clubroboticagranada/semaforo-optico-acustico-CO2/README.md

# Semáforo óptico-acústico de CO2 y nivel de ruido
Veremos como crear y programar el dispositivo.

[Acceso a los contenidos](https://clubroboticagranada.github.io/semaforo-optico-acustico-CO2/)
