clubroboticagranada/semaforo-optico-acustico-CO2/docs/modular/modular.md

# Versión modular

Se trata de la versión dirigida a usuarios con cierta experiencia en trabajo con placas tipo Arduino y sensores diversos.

La opción adoptada permite el cableado del equipo final sin necesidad de utilizar placas breadboard al usar la placa UNO con pines extendidos de Keyestudio y que todos los sensores disponen de conexiones de pines tipo dupont.

A continuación tenemos una tabla a modo de lista de materiales gráfica con enlaces a sitios de compra.

<center>

| Cantidad | Descripción | Imagen |
|:-:|---|:-:|
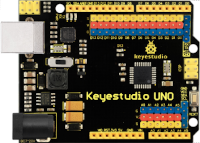
[picture p13: docs/img/modular/i1.png]
Ks0172-UNO pines extendidos
| 1 |keyestudio UNO con inteface de pines extendidos |  |
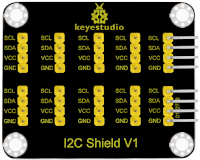
[picture p14: docs/img/modular/i2.png]
KS0392-HUB I2C
| 1 | Placa de conversión tipo HUB I2C |  |
| 1 | Sensor de Dioxido de Carbono | KS0457-CCS811-sensor CO2 |
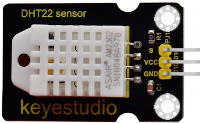
[picture p15: docs/img/modular/i4.png]
KS0430-sensor de temperatura y humedad
| 1 | Sensor de temperatura y humedad relativa |  |
| 1 | Amplificador de 2W de potencia| KS0374-amplificador de 2W de potencia |
| 1 | Micrófono sensor de sonido ambiente | KS0035-micrófono |
| 1 | Barómetro BMP280| KS0405-BMP280 |
| 1 | Pantalla LCD 1602 I2C | Ks0061-LCD |
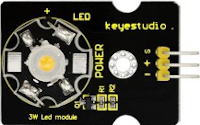
[picture p16: docs/img/modular/i9.png]
Ks0010-LED 3W
| 3 | LED de 3W |  |
| 1 | Alimentador Arduino 12V - 2A | Alimentador |
| 1 | Interruptor de panel deslizante 1P2T SPDT de 0.5A 50V CC | Interruptor de panel deslizante 1P2T SPDT de 0.5A 50V CC |
| 1 | Cables tipo dupont H-H de 10 cm y 4 pines| Cables H-H de 10 cm |
| 4 | Cable tipo dupont H-H de 30 cm y 3 pines| Cables dupont H-H |
| 3 | Cable tipo dupont H-H de 30 cm y 4 pines| Cables dupont H-H |
| 1 | Cable tipo dupont H-H de 30 cm y 5 pines| Cables dupont H-H |
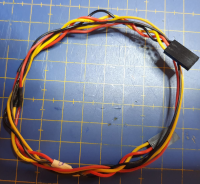
[picture p17: docs/img/modular/ic3.png]
Cable para color verde
| 1 | Cable tipo dupont H-H de 40 cm y 3 pines|  |
| 1 | Cable tipo dupont H-H de 45 cm y 3 pines| Cable para color amarillo |
| 1 | Cable tipo dupont H-H de 50 cm y 3 pines| Cable para color rojo |
| 1 | **OPCIONAL** Shield WiFi ESP01 <br> [Ver nota final Introducción](../index.md) </br> | KS0385-Shield WiFi ESP01 |
| 1 | **OPCIONAL** Módulo ESP8266 WiFi ESP01  <br> [Ver nota final Introducción](../index.md) </br> | Módulo ESP8266 WiFi ESP01 |

</center>
