clubroboticagranada/semaforo-optico-acustico-CO2/docs/Miscelanea/soft.md

# Software utilizado

* Dibujo 3D [FreeCAD 0.18 / FreeCAD 0.19](https://www.freecadweb.org/)
  
* Sistema operativo: [Ubuntu 20.04 LTS (Focal Fosa)](https://releases.ubuntu.com/bionic/)
  
* Paquete ofimático de referencia: [LibreOffice 7.0](https://es.libreoffice.org/)
  
* Librería Material para MkDocs
  
* [Visual Studio Code](https://code.visualstudio.com/)
  
* Creación de GIF animados para Ubuntu [Peek](https://ubunlog.com/peek-gif-animados-ubuntu/)
  
* Sistema principal de capturas de pantalla: [Shutter 0.94](http://shutter-project.org)
  
* Sistema secundario de capturas de pantalla: [Flameshot 0.6.0](https://flameshot.js.org/#/?id=flameshot-060)
  
* Dibujo 2D vectorial [Inkscape 1.0](https://inkscape.org/es/)

* Retoque de imágenes [GIMP 2.10.14](https://www.gimp.org/)

* Software online de programación por bloques creado por Juanjo López [ArduinoBlocks](http://www.arduinoblocks.com/) junto con el programa [connector](http://www.arduinoblocks.com/web/site/abconnector) que nos permitirá grabar los programas en la placa.

* [Libros y documentación](http://www.arduinoblocks.com/web/site/doc) sobre ArduinoBlocks
