clubroboticagranada/semaforo-optico-acustico-CO2/docs/mcu/mcu.md

# Versión Node MCU

Se trata de la versión dirigida a usuarios con bastante experiencia en trabajo con placas tipo Arduino y sensores diversos.

Requiere conocimientos de IoT.
