clubroboticagranada/semaforo-optico-acustico-CO2/docs/Miscelanea/webgrafia.md

# Webgrafía y bibliografía

***
* [Wikipedia](https://es.wikipedia.org/wiki/Wikipedia:Portada)

* [Carburos metálicos](http://www.carburos.com/), páginas 8 y 9 de la [Ficha Técnica de Seguridad número 300000000020](http://www.carburos.com/microsite/es/selector-gases-soldadura/pdf/SDS/CO2.pdf)  

* [Definiciones de términos usuales](https://www.nj.gov/health/eoh/rtkweb/documents/fs/0343sp.pdf) del Departamento de Salud de New Jersey.

* [Ficha de seguridad oficial del CO2](http://www.ilo.org/dyn/icsc/showcard.display?p_card_id=21&p_edit=&p_version=2&p_lang=es)

* Instituto para la Salud Geoambiental, [El dióxido de carbono](https://www.saludgeoambiental.org/dioxido-carbono-co2#:~:text=El%20di%C3%B3xido%20de%20carbono%20CO2,a%20vida%20en%20la%20Tierra)

* Artículo de la International Journal of Emergency Medicine [Carbon dioxide poisoning: a literature review of an often forgotten cause of intoxication in the emergency department](https://intjem.biomedcentral.com/articles/10.1186/s12245-017-0142-y)

* Artículo Editorial de BMJ: [Riesgos de transmisión de covid-19 en distintas situaciones](https://www.bmj.com/content/370/bmj.m3223)

Artículo del Centro Canadiense de Seguridad y Salud Ocupacional (CCSSO) sobre [Dióxido de Carbono - Efectos en la Salud](http://www.ccsso.ca/oshanswers/chemicals/chem_profiles/carbon_dioxide/health_cd.html)

* Muy recomendable para otros muchos temas el [Canal Youtube de Andreas Spiess](https://www.youtube.com/c/AndreasSpiess/about)

* Página web [SENSORSIOT/](https://www.sensorsiot.org/) de Andreas Spiess
