clubroboticagranada/semaforo-optico-acustico-CO2/docs/mega/mega.md

# Versión IoT con placa MEGA

Se trata de una versión muy similar a la modular pero solucionando los problemas de memoria de la versión con UNO y dando conectividad via WiFi al sistema para subir datos a la nube.

Básicamente todo es igual pero se aprovecha para implementar algunas mejoras respecto al prototipo modular y se incluye información referente a MQTT y WiFi interesante.
