clubroboticagranada/semaforo-optico-acustico-CO2/docs/Miscelanea/about.md

# Autores

<center>

| Angela Pozo | Federico Coca |
|:-:|:-:|
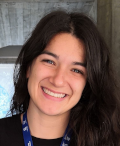
[picture p36: docs/img/angela.png]
Foto
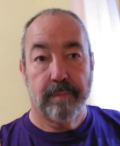
[picture p37: docs/img/YO.png]
Foto de perfil
| |  |
|[Github](https://github.com/ankgiel) | [GitHub](https://github.com/fgcoca) |
|[Twitter](http://twitter.com/ankgiel) | [Twitter](https://twitter.com/fgcoca) |
|[Instagram](https://www.instagram.com/ankgiel/?hl=es) |[Instagram](https://www.instagram.com/cocafederico/?hl=es) |
|[Mas información](../Miscelanea/about_angela.md) | [Mas información](https://fgcoca.github.io/Como-documento/about/) |

</center>
