clubroboticagranada/semaforo-optico-acustico-CO2/docs/Miscelanea/about_angela.md

# Un poco de mi huella digital

**Ángela Pozo Mateos** 

Soy **graduada en Ingeniería Informática** con un máster de profesorado en la especialidad de informática y, actualmente, trabaja como profesora en un centro de formación profesional para los ciclos de la familia de informática y telecomunicaciones.

Mis intereses están centrados en la creación de proyectos electrónicos con aplicaciones informáticas, siempre fomentando el uso de nuevas tecnologías y software libre. 

Trabajo en varios proyectos que tienen como objetivo promover la igualdad de género en las tecnologías: 

* proyecto [Seré Ingeniera](https://sereingeniera.ugr.es/)
* talleres para la Feria de las Ingenierías
* talleres para la semana de la Mujer y la niña en la Ciencia
* participación en la noche Europea de los Investigadores.
  
Estoy comprometida con la cultura Maker siendo miembro de:

* [ETSIIT Makers](http://www.etsiitmakers.org/)
* [Club Robótica Granada](https://clubroboticagranada.github.io/)
