clubroboticagranada/semaforo-optico-acustico-CO2/docs/img/sobre-co2/i1.pdf

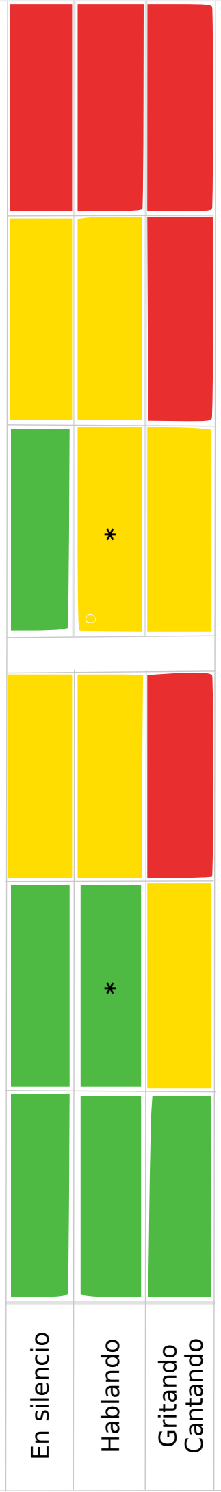
[picture p38: figure]
En silencio; Hablando; Gritando; Cantando
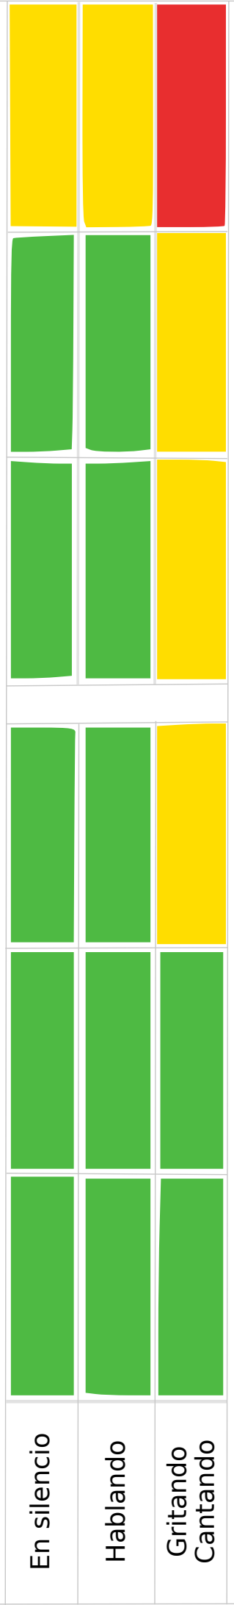
[picture p39: figure]
En silencio; Hablando; Gritando; Cantando
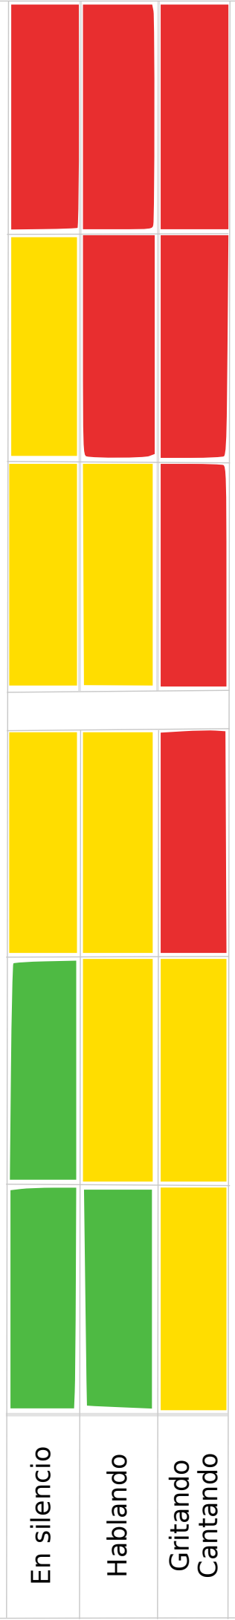
[picture p40: figure]
En silencio; Hablando; Gritando; Cantando

Tipo y nivel de
actividad del
grupo

Baja ocupación Alta ocupación

Aire libre y

bien ventilado

Interior y

bien ventilado

Mal

ventilado

Aire libre y

bien ventilado

Interior y

bien ventilado

Mal

ventilado

Con mascarilla bien colocada y contacto durante poco tiempo

Con mascarilla bien colocada y contacto durante mucho tiempo Sin mascarilla o mal colocada y contacto durante poco tiempo

Sin mascarilla o mal colocada y contacto durante mucho tiempo

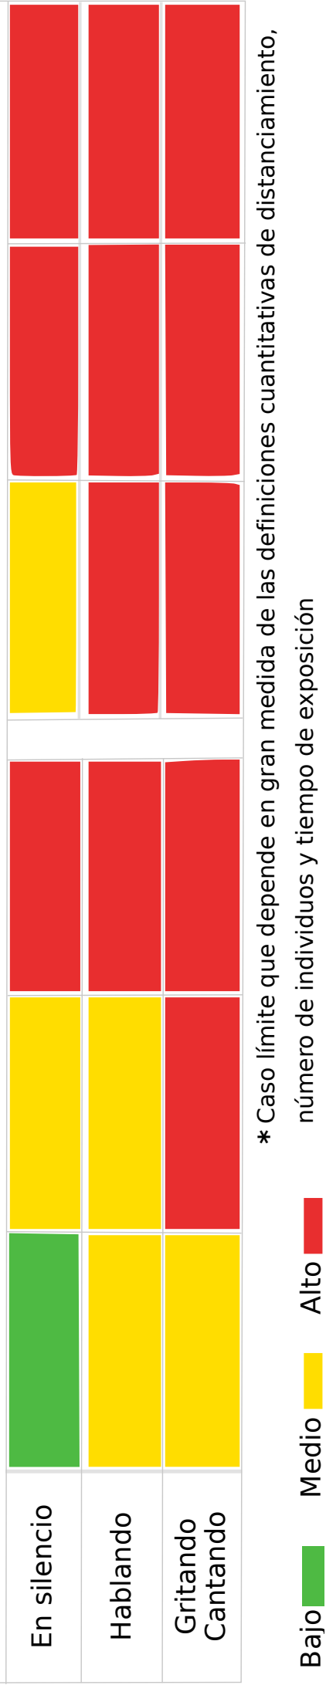
[picture p41: figure]
En silencio; Hablando; Gritando; Cantando; Bajo Medio Alto

Caso límite que depende en gran medida de las definiciones cuantitativas de distanciamiento,

número de individuos y tiempo de exposición
