clubroboticagranada/semaforo-optico-acustico-CO2/docs/modular/pinout/Ks0172-keyestudio-UNO.png

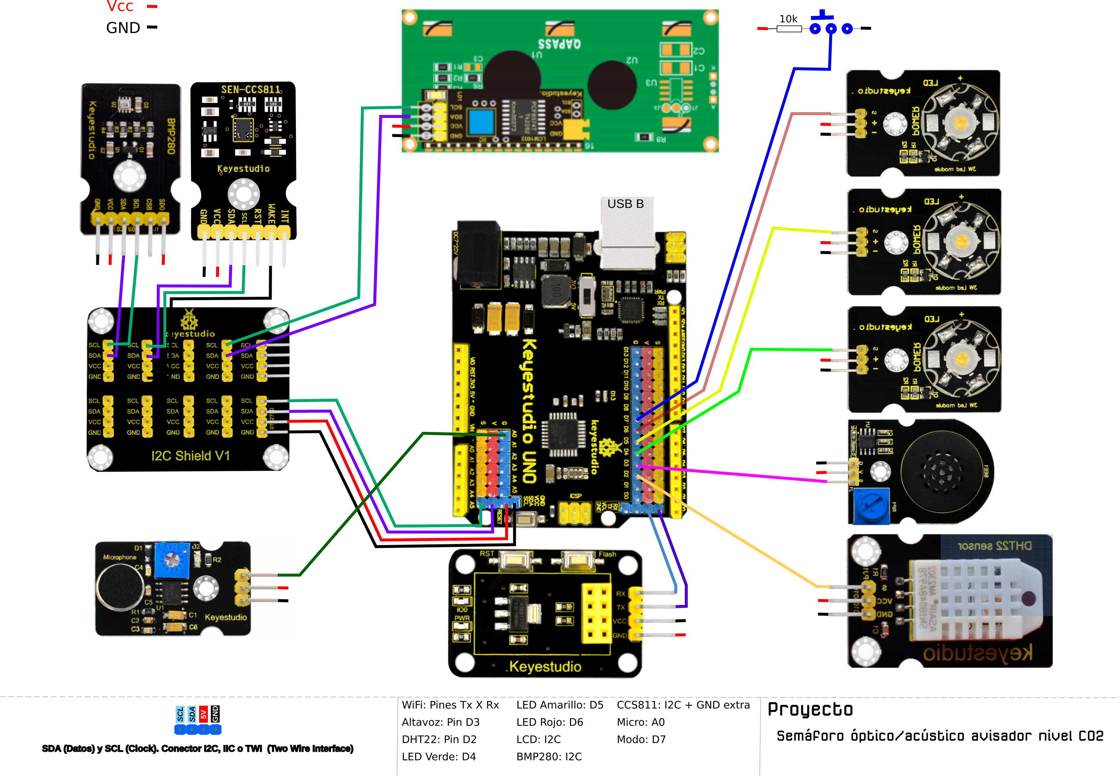
docs/modular/pinout/Ks0172-keyestudio-UNO.png
