clubroboticagranada/semaforo-optico-acustico-CO2/site/img/mega/sensor/i5ant.png

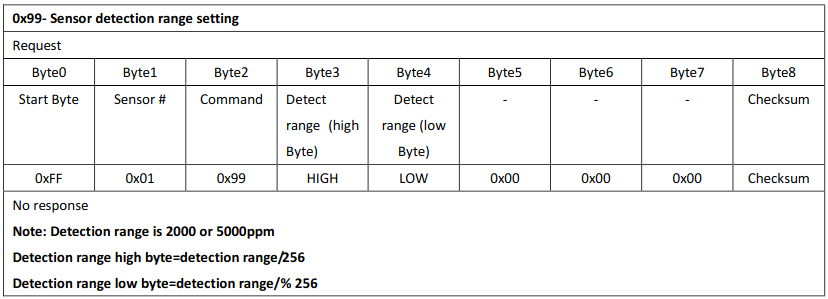
site/img/mega/sensor/i5ant.png
