clubroboticagranada/semaforo-optico-acustico-CO2/site/img/mega/sensor/i6ant.png

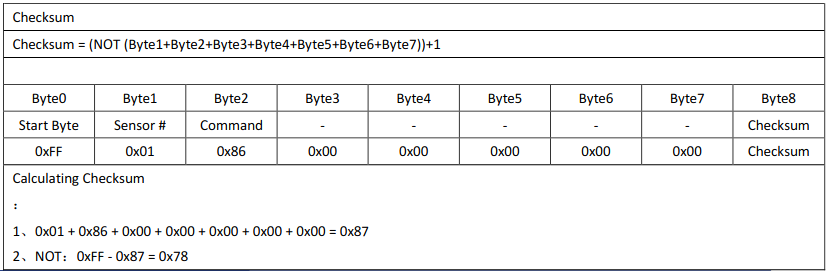
site/img/mega/sensor/i6ant.png
