clubroboticagranada/semaforo-optico-acustico-CO2/site/img/modular/firmware/i8.png

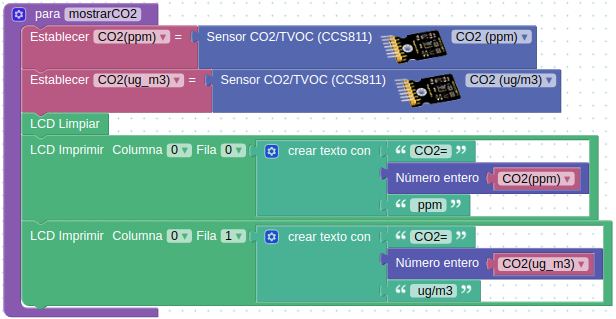
site/img/modular/firmware/i8.png
