clubroboticagranada/semaforo-optico-acustico-CO2/site/img/modular/firmware/i9.png

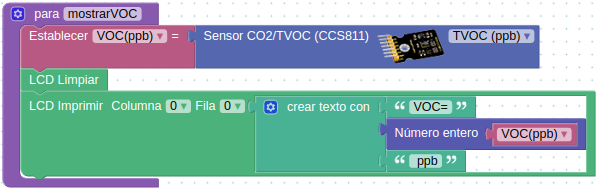
site/img/modular/firmware/i9.png
