clubroboticagranada/semaforo-optico-acustico-CO2/site/modular/pinout/imagenes-referencia/Amplificador.png

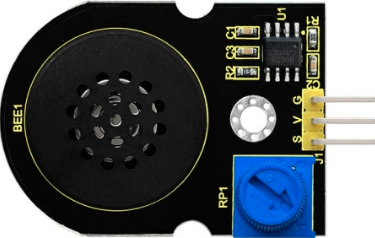
site/modular/pinout/imagenes-referencia/Amplificador.png
