clubroboticagranada/semaforo-optico-acustico-CO2/site/modular/pinout/imagenes-referencia/DHT22.png

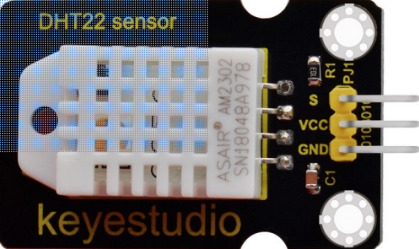
site/modular/pinout/imagenes-referencia/DHT22.png
