clubroboticagranada/semaforo-optico-acustico-CO2/site/modular/pinout/imagenes-referencia/Hub-I2C.png

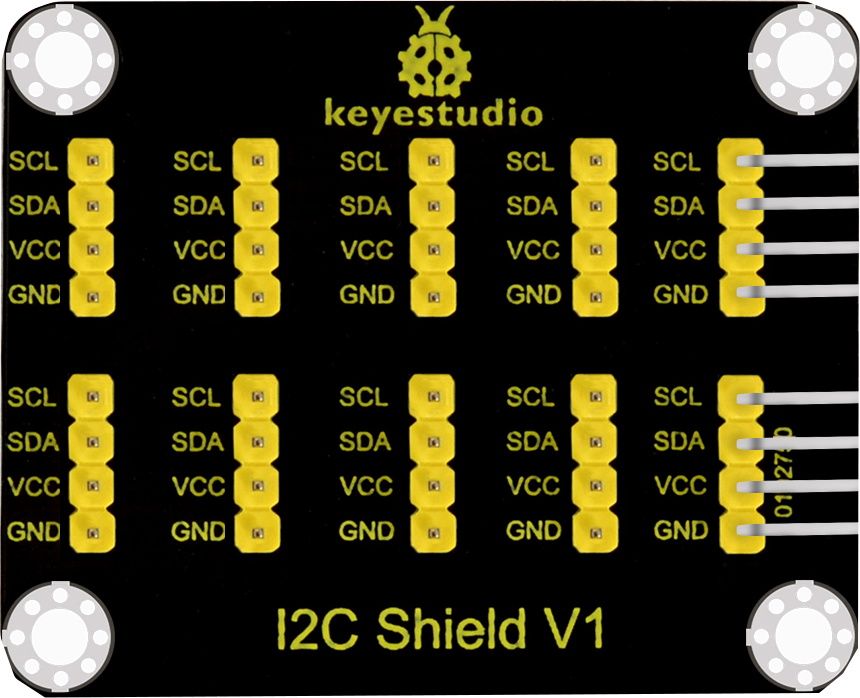
site/modular/pinout/imagenes-referencia/Hub-I2C.png
