clubroboticagranada/semaforo-optico-acustico-CO2/site/modular/pinout/imagenes-referencia/LCD1602.png

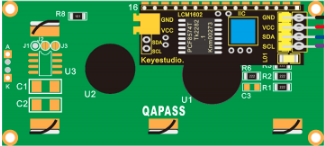
site/modular/pinout/imagenes-referencia/LCD1602.png
