clubroboticagranada/semaforo-optico-acustico-CO2/site/modular/pinout/imagenes-referencia/LED-3W.png

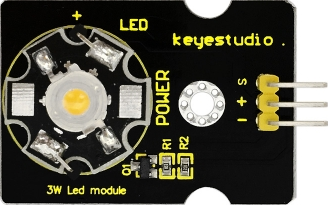
site/modular/pinout/imagenes-referencia/LED-3W.png
