clubroboticagranada/semaforo-optico-acustico-CO2/site/modular/pinout/imagenes-referencia/Microfono.png

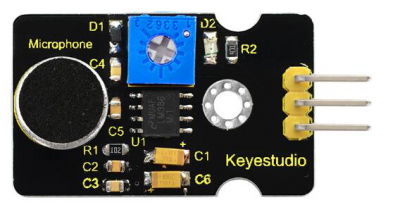
site/modular/pinout/imagenes-referencia/Microfono.png
