clubroboticagranada/semaforo-optico-acustico-CO2/site/modular/pinout/imagenes-referencia/WiFi.png

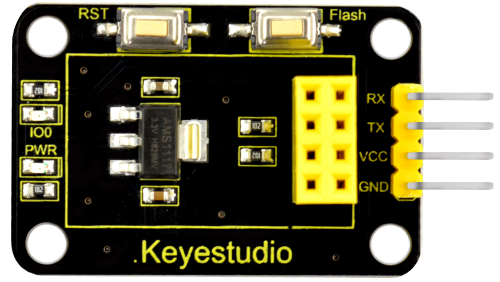
site/modular/pinout/imagenes-referencia/WiFi.png
