clubroboticagranada/semaforo-optico-acustico-CO2/docs/3D/design/design.FCStd

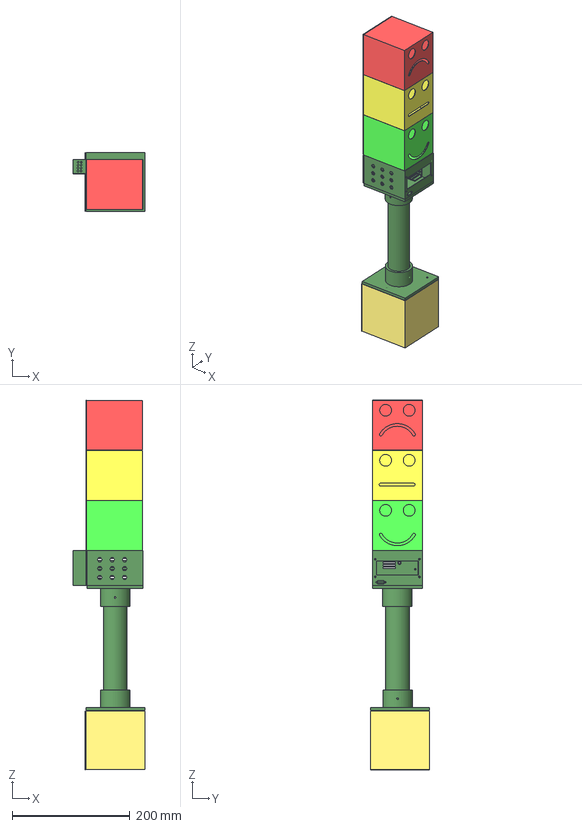
[picture p54: CAD file, 2020-10-14]
docs/3D/design/design.FCStd
122.0 x 100.2 x 628.5 mm
tapa-posterior-verde-e
tubo-200mm-e
tapa-posterior-amarillo-e
tapa-posterior-rojo-e
separador-e
soporte-tubo-inferior-e
caja-sensores-e
verde-e
amarillo-e
rojo-e
soporte-tubo-superior-e
caja-CCS811-e
tapa-caja-CCS812-e
tapa-posterior-sensores-e
base-e
tapa-posterior-base-e
