clubroboticagranada/semaforo-optico-acustico-CO2/docs/3D/step/tapa-posterior-base.step

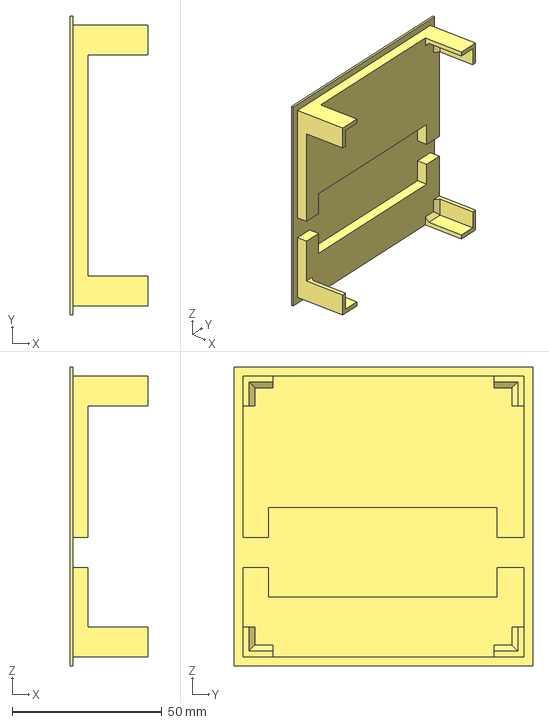
[picture p55: CAD file, 2020-10-14]
docs/3D/step/tapa-posterior-base.step
26.0 x 100.0 x 100.0 mm
