clubroboticagranada/semaforo-optico-acustico-CO2/site/3D/step/tapa-posterior-sensores.step

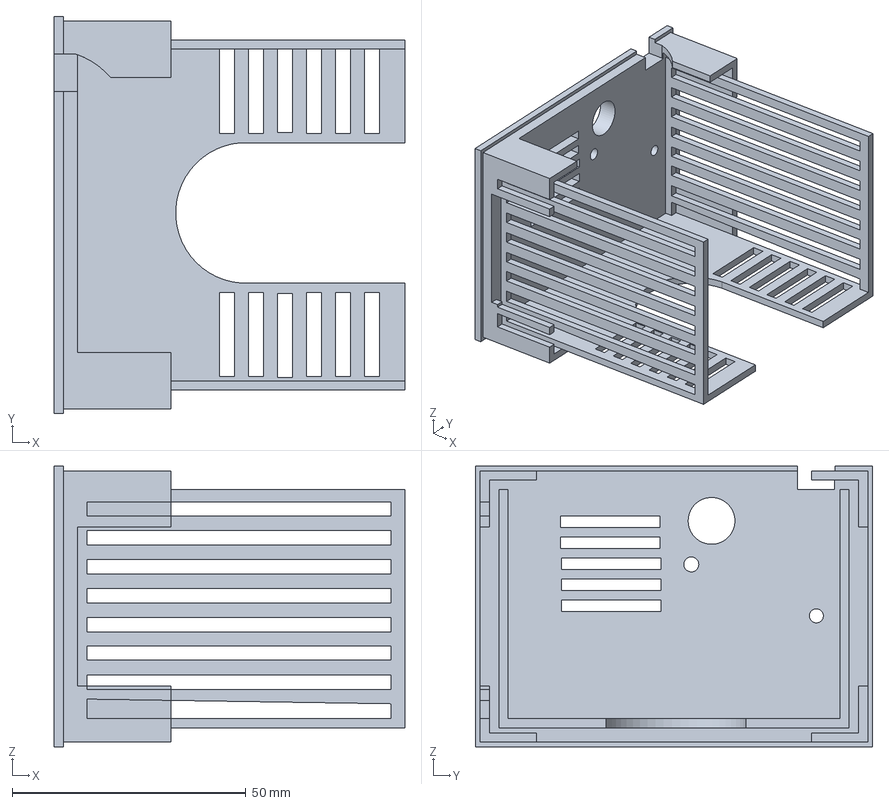
[picture p56: CAD file, 2020-10-05]
site/3D/step/tapa-posterior-sensores.step
75.0 x 84.9 x 60.0 mm
