clubroboticagranada/semaforo-optico-acustico-CO2/site/3D/step/tapa-posterior-verde.step

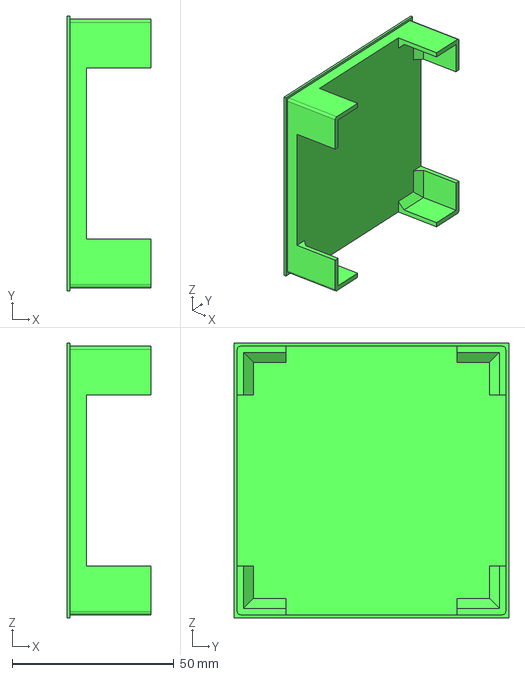
[picture p57: CAD file, 2020-10-05]
site/3D/step/tapa-posterior-verde.step
26.0 x 84.9 x 84.9 mm
