clubroboticagranada/semaforo-optico-acustico-CO2/site/3D/step/rojo.step

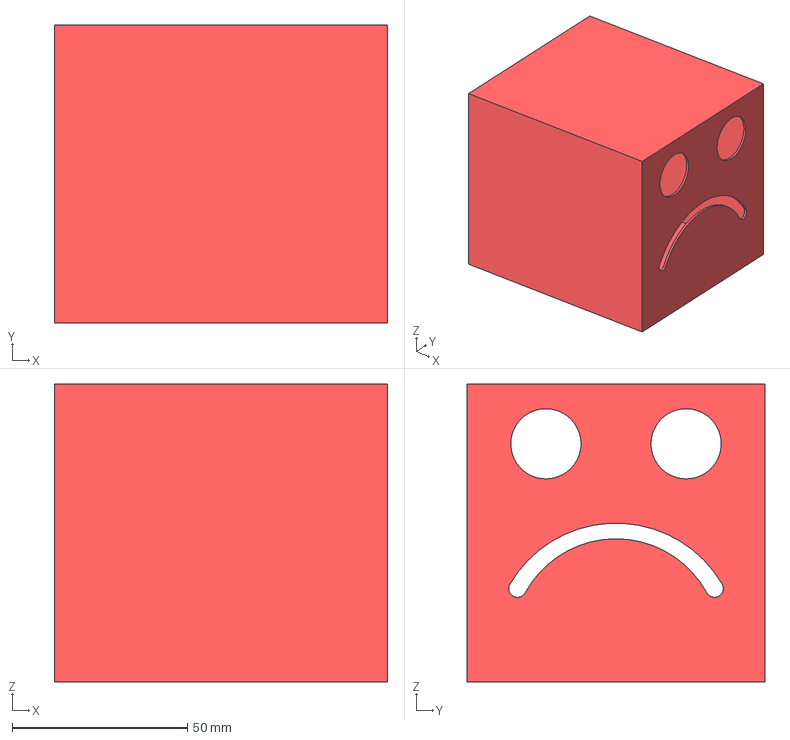
[picture p58: CAD file, 2020-10-05]
site/3D/step/rojo.step
95.0 x 84.9 x 84.9 mm
