clubroboticagranada/semaforo-optico-acustico-CO2/site/3D/step/caja-sensores.step

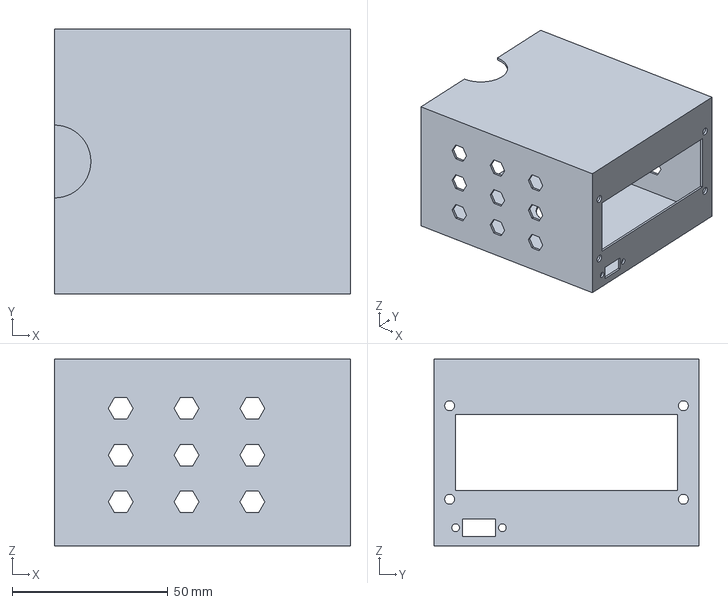
[picture p59: CAD file, 2020-10-05]
site/3D/step/caja-sensores.step
95.0 x 84.9 x 60.0 mm
