clubroboticagranada/semaforo-optico-acustico-CO2/site/3D/step/tapa-caja-CCS812.step

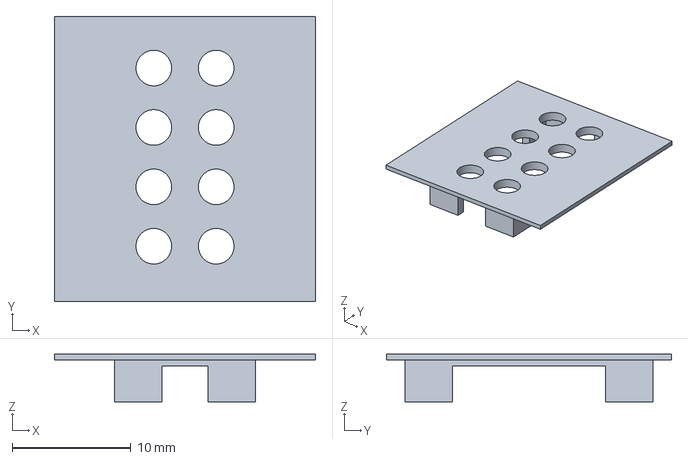
[picture p60: CAD file, 2020-10-05]
site/3D/step/tapa-caja-CCS812.step
22.0 x 24.0 x 4.00 mm
