clubroboticagranada/semaforo-optico-acustico-CO2/site/3D/step/caja-CCS811.step

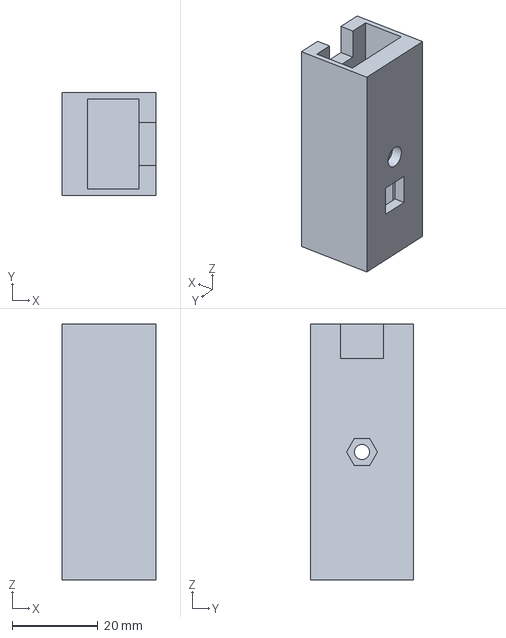
[picture p61: CAD file, 2020-10-05]
site/3D/step/caja-CCS811.step
22.0 x 24.0 x 59.6 mm
