clubroboticagranada/semaforo-optico-acustico-CO2/site/3D/step/separador.step

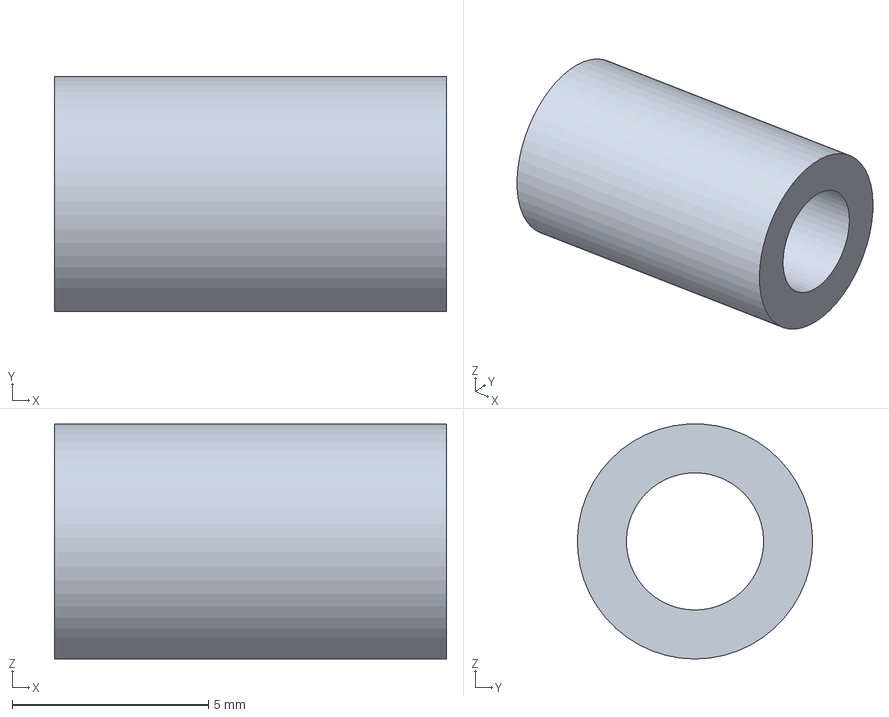
[picture p62: CAD file, 2020-10-05]
site/3D/step/separador.step
10.0 x 6.00 x 5.99 mm
