clubroboticagranada/semaforo-optico-acustico-CO2/site/3D/step/soporte-tubo-inferior.step

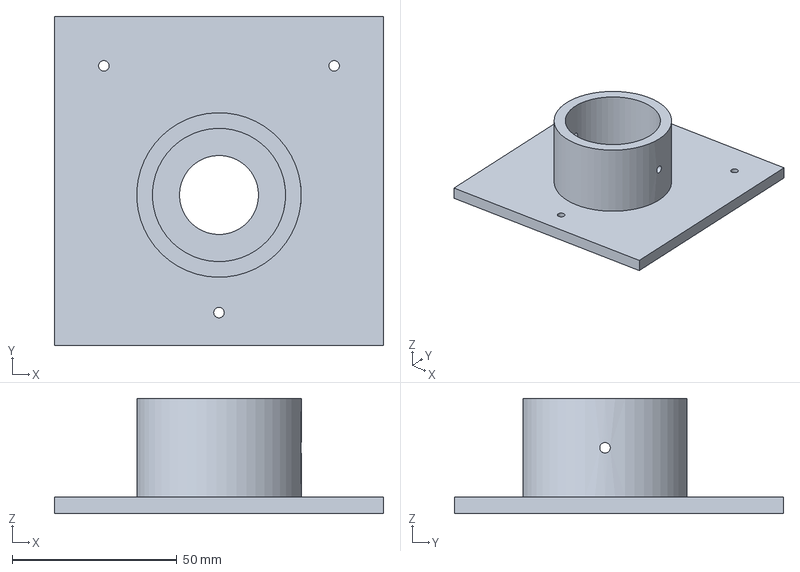
[picture p63: CAD file, 2020-10-05]
site/3D/step/soporte-tubo-inferior.step
100.0 x 100.0 x 35.0 mm
