clubroboticagranada/semaforo-optico-acustico-CO2/site/3D/step/base.step

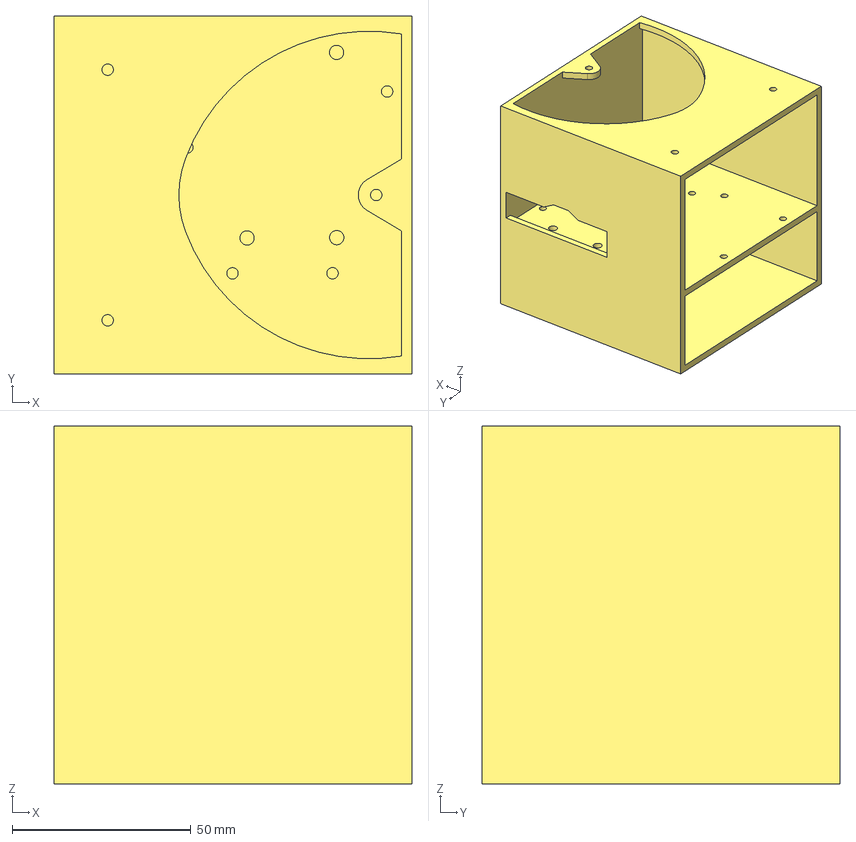
[picture p64: CAD file, 2020-10-05]
site/3D/step/base.step
100.0 x 100.0 x 100.0 mm
