clubroboticagranada/semaforo-optico-acustico-CO2/site/3D/step/tubo-200mm.step

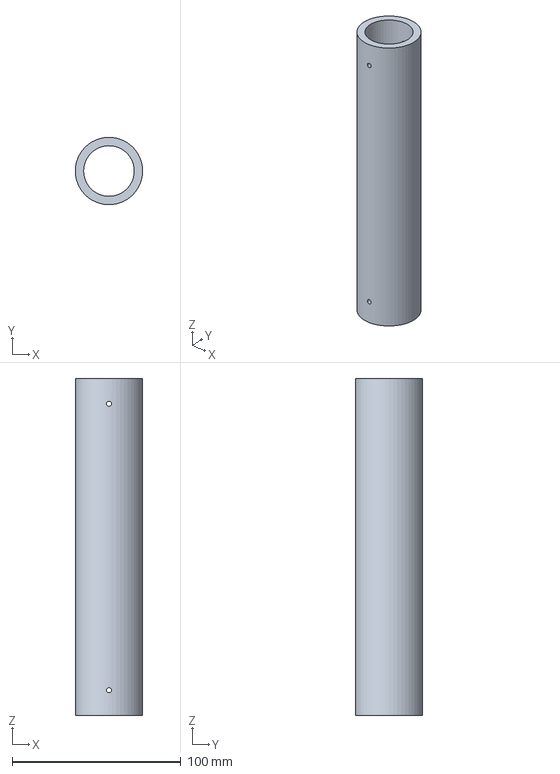
[picture p65: CAD file, 2020-10-05]
site/3D/step/tubo-200mm.step
40.0 x 40.0 x 200.0 mm
