clubroboticagranada/semaforo-optico-acustico-CO2/site/3D/step/soporte-tubo-superior.step

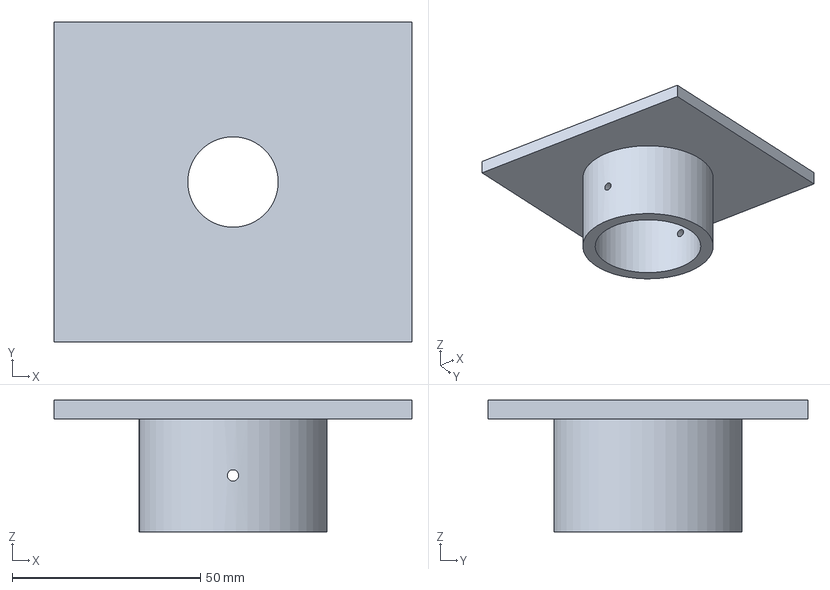
[picture p66: CAD file, 2020-10-05]
site/3D/step/soporte-tubo-superior.step
95.0 x 85.0 x 35.0 mm
