clubroboticagranada/semaforo-optico-acustico-CO2/(list of files, cad)

Other CAD files:
site/3D/step/tapa-posterior-amarillo.step
site/3D/step/tapa-posterior-rojo.step
site/3D/step/amarillo.step
site/3D/step/verde.step
docs/3D/amf/tapa-posterior-base.amf
docs/3D/stl/tapa-posterior-base.stl
site/3D/amf/amarillo.amf
site/3D/amf/base.amf
site/3D/amf/caja-CCS811.amf
site/3D/amf/caja-sensores.amf
site/3D/amf/rojo.amf
site/3D/amf/separador.amf
site/3D/amf/soporte-tubo-inferior.amf
site/3D/amf/soporte-tubo-superior.amf
site/3D/amf/tapa-caja-CCS812.amf
site/3D/amf/tapa-posterior-amarillo.amf
site/3D/amf/tapa-posterior-base.amf
site/3D/amf/tapa-posterior-rojo.amf
site/3D/amf/tapa-posterior-sensores.amf
site/3D/amf/tapa-posterior-verde.amf
site/3D/amf/tubo-200mm.amf
site/3D/amf/verde.amf
site/3D/stl/amarillo.stl
site/3D/stl/base.stl
site/3D/stl/caja-CCS811.stl
site/3D/stl/caja-sensores.stl
site/3D/stl/rojo.stl
site/3D/stl/separador.stl
site/3D/stl/soporte-tubo-inferior.stl
site/3D/stl/soporte-tubo-superior.stl
site/3D/stl/tapa-caja-CCS812.stl
site/3D/stl/tapa-posterior-amarillo.stl
site/3D/stl/tapa-posterior-base.stl
site/3D/stl/tapa-posterior-rojo.stl
site/3D/stl/tapa-posterior-sensores.stl
site/3D/stl/tapa-posterior-verde.stl
site/3D/stl/tubo-200mm.stl
site/3D/stl/verde.stl
