clubroboticagranada/semaforo-optico-acustico-CO2/docs/modular/pinout/Ks0172-keyestudio-UNO.pdf

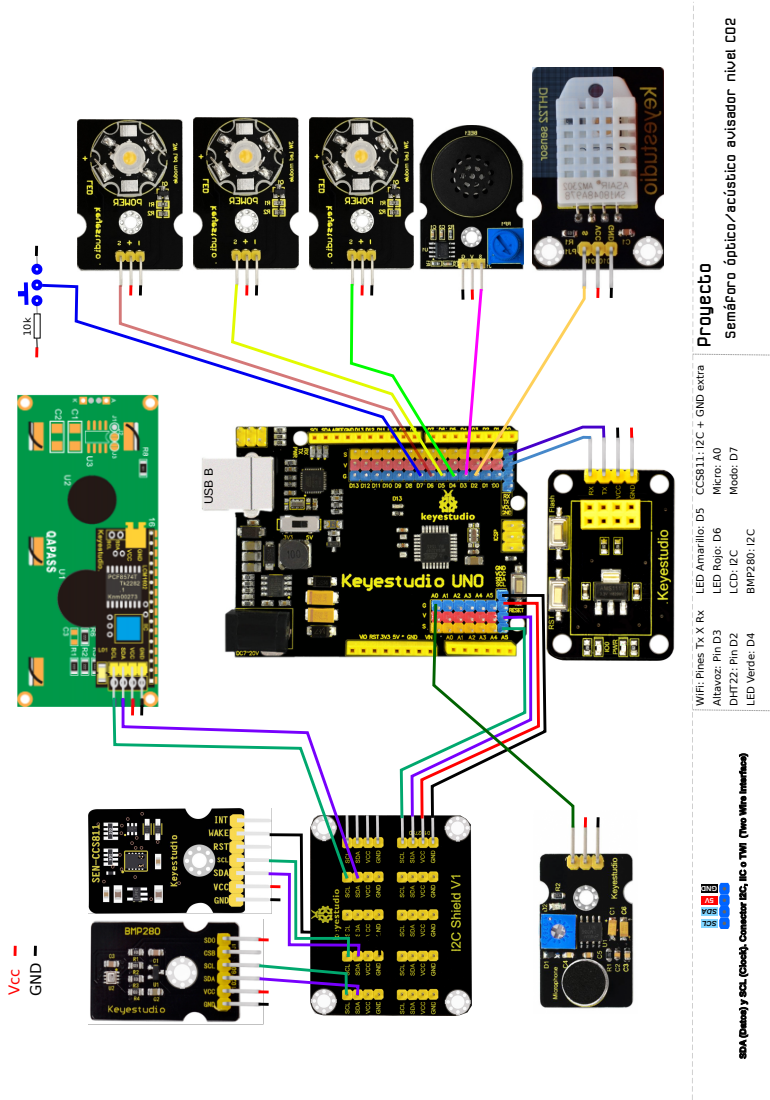
[picture p111: page 1]
USB B; Vcc; GND 10k; Proyecto; Altavoz: Pin D3; DHT22: Pin D2; LED Verde: D4; LED Amarillo: D5; LED Rojo: D6; LCD: I2C; BMP280: I2C; CCS811: I2C + GND extra; Micro: A0; Modo: D7

Semáforo óptico/acústico avisador nivel CO2

WiFi: Pines Tx X Rx

SDA (Datos) y SCL (Clock). Conector I2C, IIC o TWI (Two Wire Interface)
