clubroboticagranada/semaforo-optico-acustico-CO2/(commit log)

2020-09-10 Primera subida para deply de prueba
2020-09-13 Probar de otra forma
2020-09-13 Se introduce una nueva entrada de indice y se modifica el archivo index anterior
2020-09-13 Arreglo enlace pdf que estaba mal
2020-10-05 Subida 3D
    [amarillo.amf, amarillo.step, amarillo.stl, base.amf, base.step, base.stl, caja-CCS811.amf, caja-CCS811.step]
2020-10-05 Actualizar site tras deploy
    [amarillo.amf, amarillo.step, amarillo.stl, base.amf, base.step, base.stl, caja-CCS811.amf, caja-CCS811.step]
2020-10-14 Actualizacion 3D
    [design.FCStd, tapa-posterior-base.amf, tapa-posterior-base.step, tapa-posterior-base.stl]
2020-10-14 sincronizacion remoto y local
    [design.FCStd, tapa-posterior-base.amf, tapa-posterior-base.step, tapa-posterior-base.stl]
2020-10-26 Añadido la comparación CO2 eCO2
2020-11-17 Correccion de erratas en unidades
